davols/tiny-engineer/hardware/boards/main-control-board/main-control-board-rev-3-preview.jpg

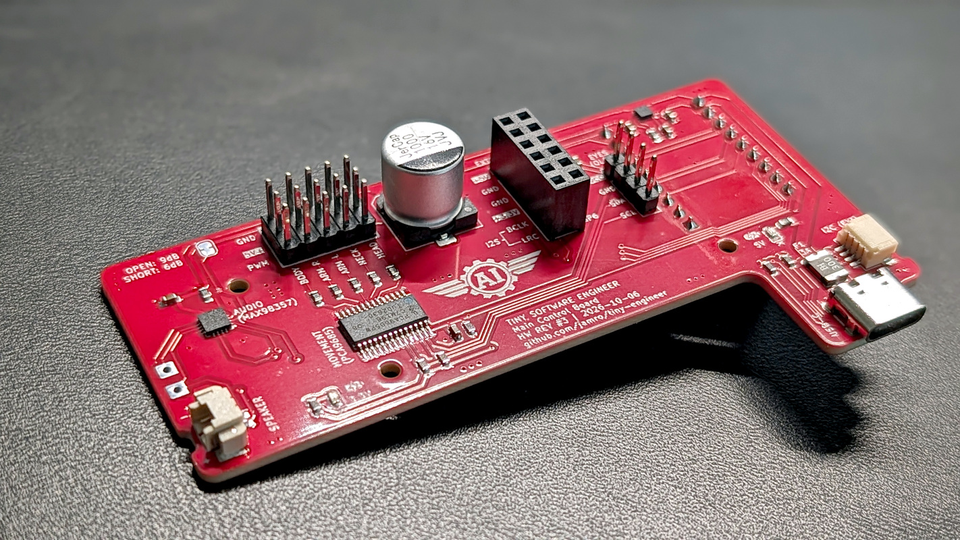
hardware/boards/main-control-board/main-control-board-rev-3-preview.jpg
