davols/tiny-engineer/3d_models/parts/es9051/step/BellyJoint.step

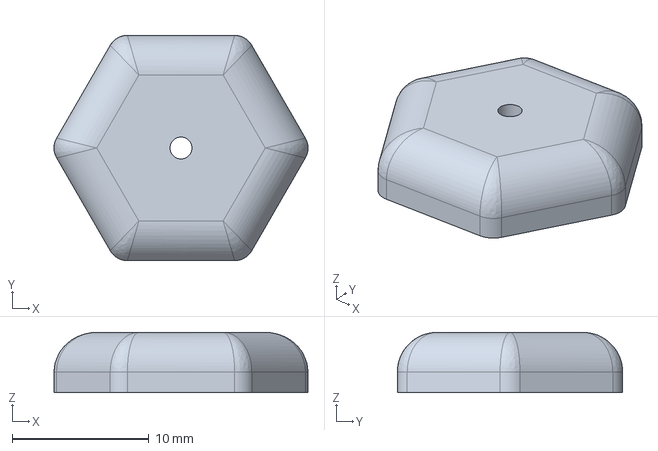
[picture p2: CAD file, 2026-10-21]
3d_models/parts/es9051/step/BellyJoint.step
18.6 x 16.5 x 4.40 mm
