davols/tiny-engineer/3d_models/parts/es9051/step/SeatLeft.step

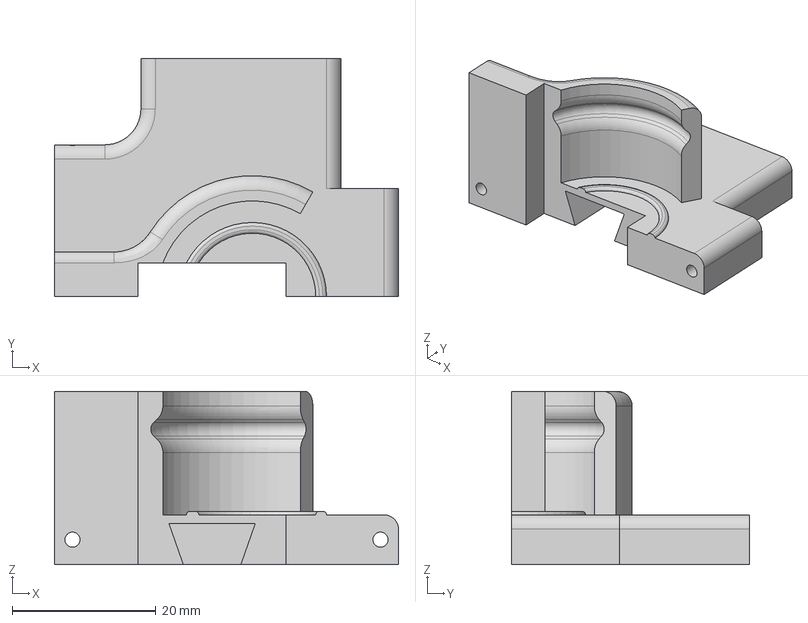
[picture p5: CAD file, 2026-10-20]
3d_models/parts/es9051/step/SeatLeft.step
47.8 x 33.1 x 24.0 mm
