davols/tiny-engineer/3d_models/parts/fs0307/step/BottomCover.step

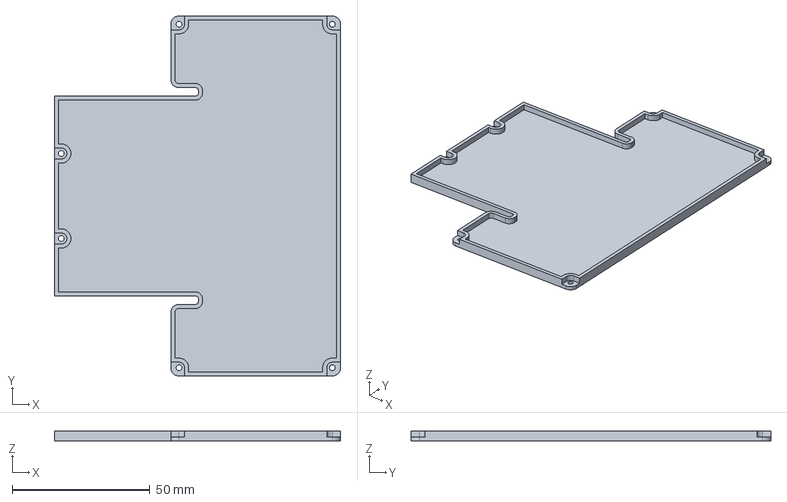
[picture p6: CAD file, 2026-10-20]
3d_models/parts/fs0307/step/BottomCover.step
103.8 x 130.6 x 3.80 mm
