davols/tiny-engineer/3d_models/parts/hd1370a/step/SeatRight.step

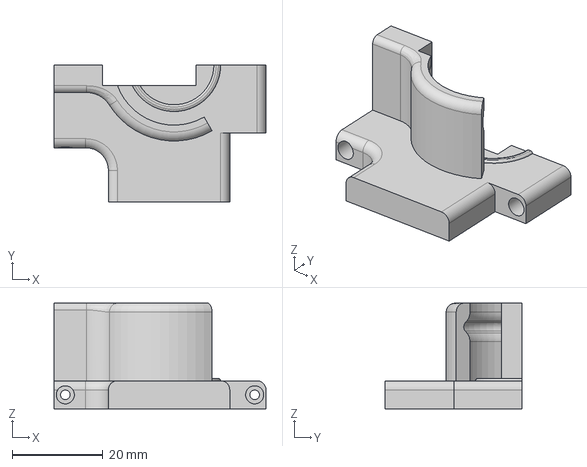
[picture p7: CAD file, 2026-10-20]
3d_models/parts/hd1370a/step/SeatRight.step
46.8 x 30.3 x 23.3 mm
