davols/tiny-engineer/3d_models/parts/sg90/step/SeatRight.step

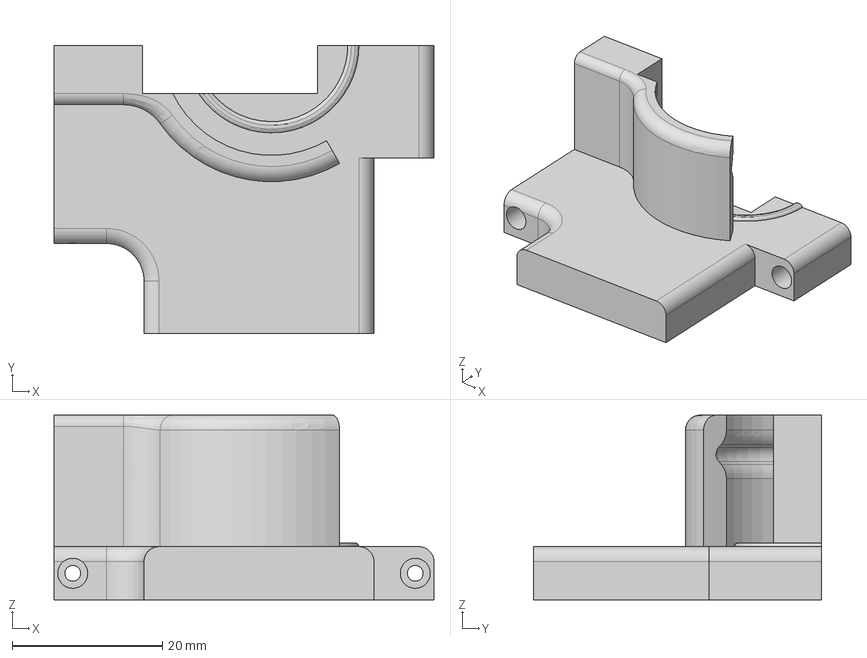
[picture p8: CAD file, 2026-10-20]
3d_models/parts/sg90/step/SeatRight.step
50.7 x 38.4 x 24.6 mm
