davols/tiny-engineer/3d_models/parts/es9051/step/BottomCover.step

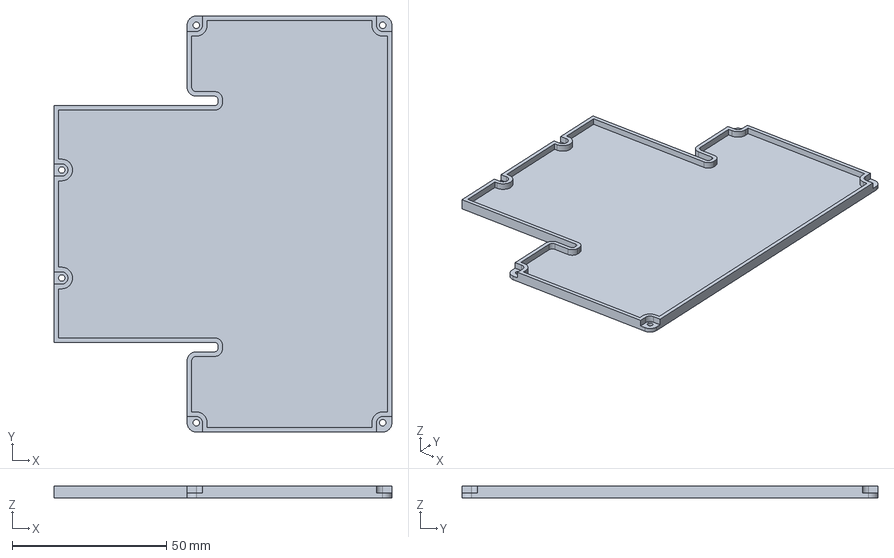
[picture p9: CAD file, 2026-10-20]
3d_models/parts/es9051/step/BottomCover.step
109.5 x 134.8 x 3.80 mm
