davols/tiny-engineer/3d_models/parts/fs0307/step/SeatLeft.step

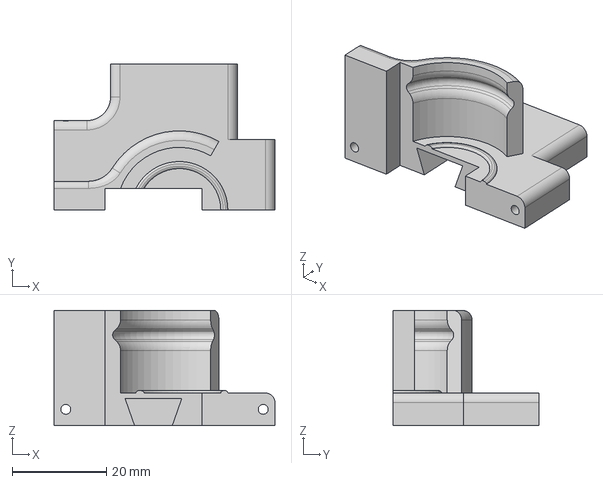
[picture p10: CAD file, 2026-10-20]
3d_models/parts/fs0307/step/SeatLeft.step
46.9 x 31.0 x 24.4 mm
