davols/tiny-engineer/3d_models/parts/sg90/step/BottomCover.step

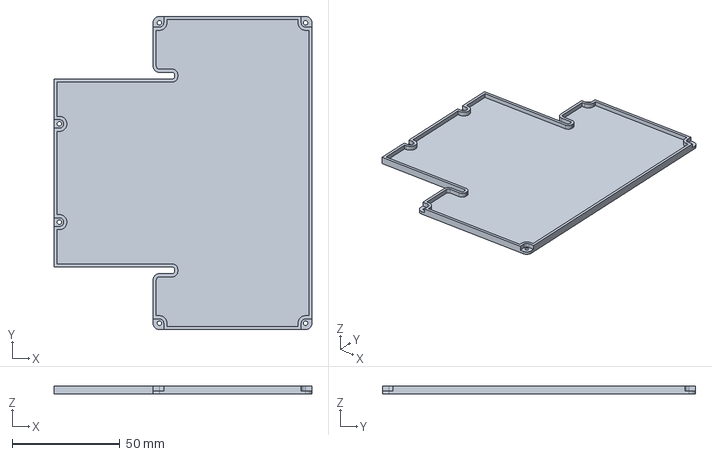
[picture p11: CAD file, 2026-10-20]
3d_models/parts/sg90/step/BottomCover.step
119.8 x 145.4 x 3.80 mm
