davols/tiny-engineer/3d_models/parts/fs0307/step/PartsSetB.step

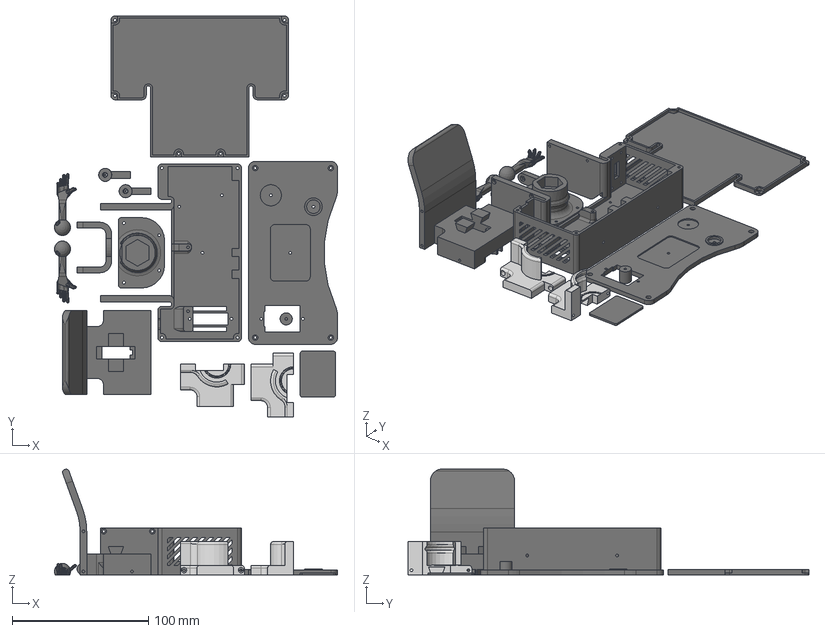
[picture p12: CAD file, 2026-10-20]
3d_models/parts/fs0307/step/PartsSetB.step
208.3 x 294.8 x 77.8 mm
