davols/tiny-engineer/3d_models/parts/hd1370a/step/PartsSetB.step

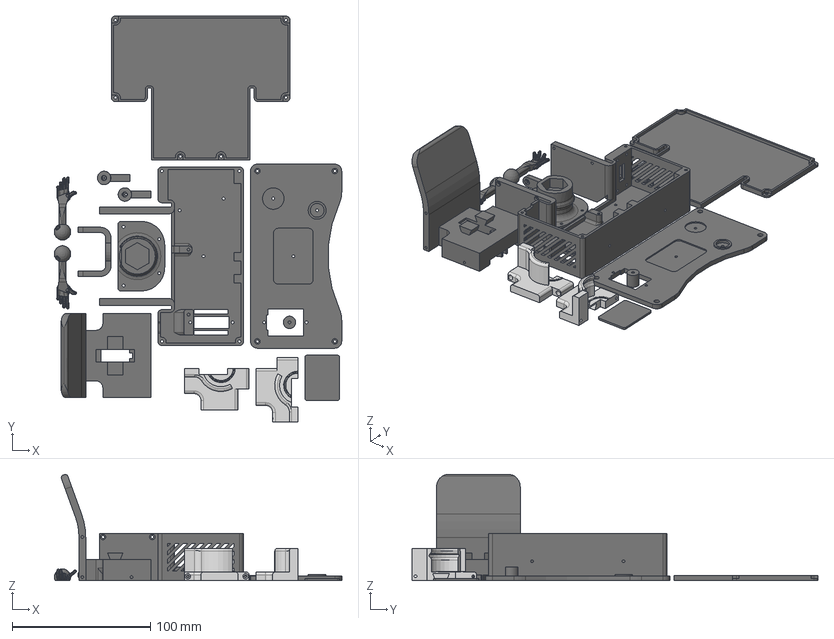
[picture p13: CAD file, 2026-10-20]
3d_models/parts/hd1370a/step/PartsSetB.step
207.9 x 293.6 x 76.8 mm
