davols/tiny-engineer/3d_models/parts/es9051/step/Belly.step

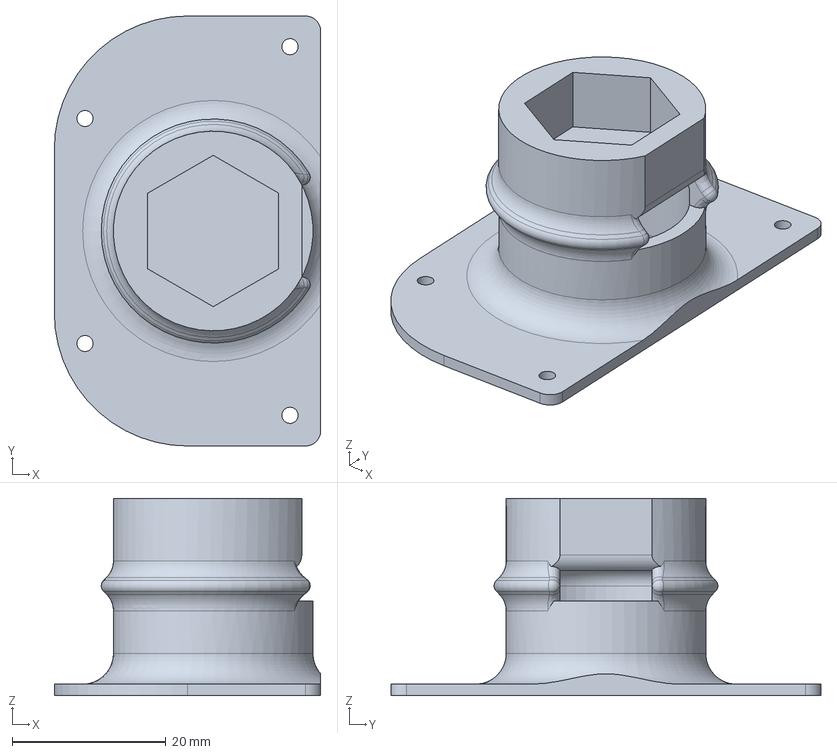
[picture p16: CAD file, 2026-10-20]
3d_models/parts/es9051/step/Belly.step
34.7 x 56.0 x 25.7 mm
