davols/tiny-engineer/3d_models/parts/fs0307/step/Belly.step

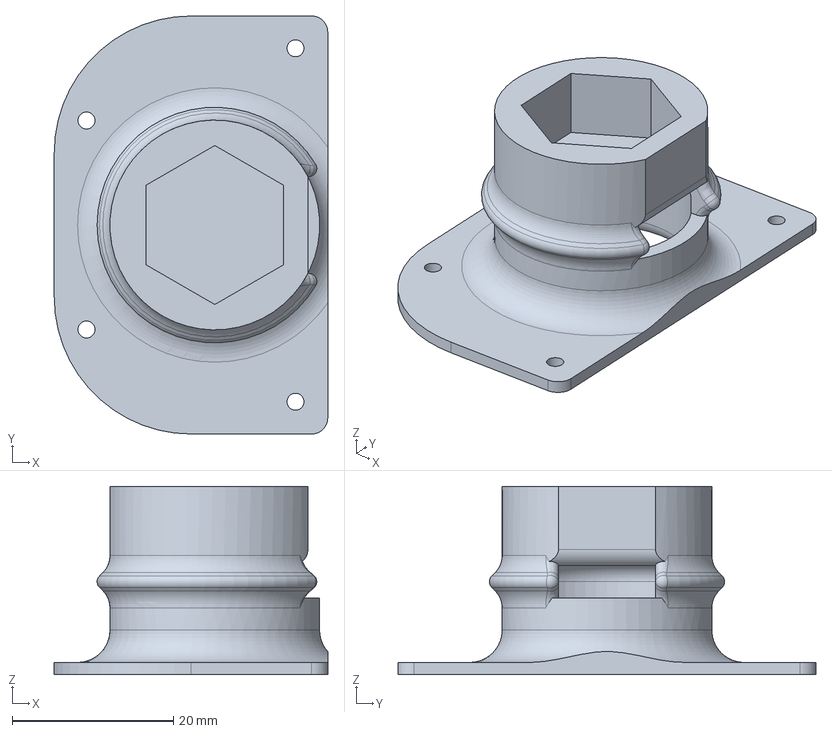
[picture p17: CAD file, 2026-10-20]
3d_models/parts/fs0307/step/Belly.step
33.9 x 51.8 x 23.3 mm
