davols/tiny-engineer/3d_models/parts/hd1370a/step/PartsSetA.step

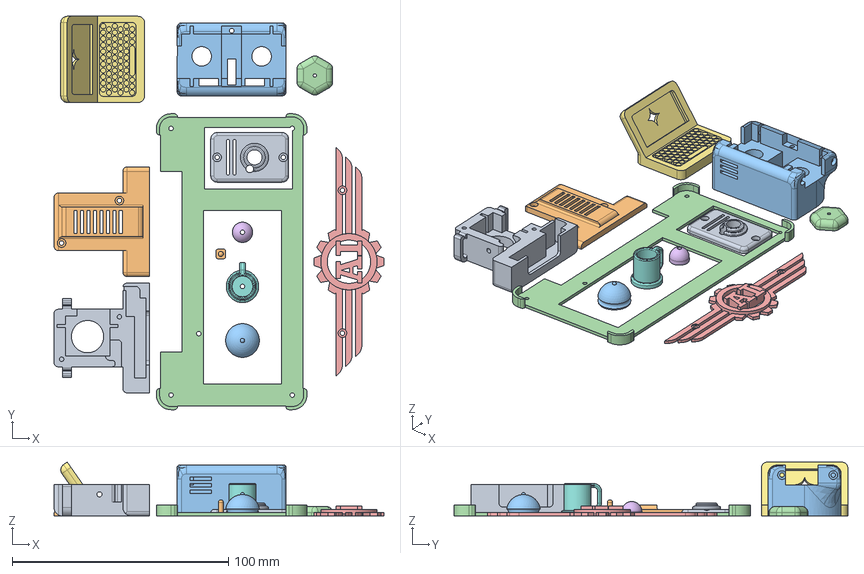
[picture p18: CAD file, 2026-10-20]
3d_models/parts/hd1370a/step/PartsSetA.step
152.5 x 181.8 x 24.9 mm
