davols/tiny-engineer/3d_models/parts/sg90/step/Belly.step

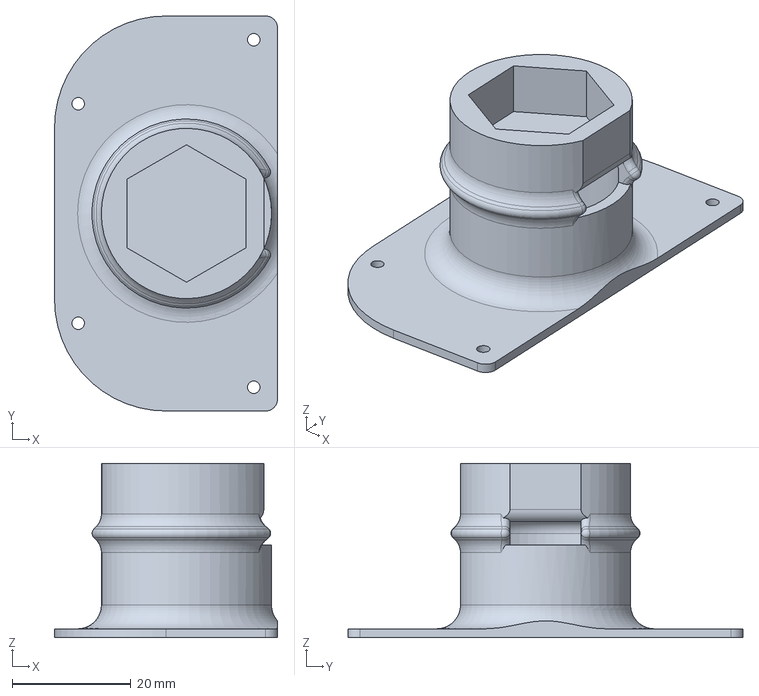
[picture p19: CAD file, 2026-10-20]
3d_models/parts/sg90/step/Belly.step
37.6 x 66.6 x 29.4 mm
