davols/tiny-engineer/3d_models/parts/fs0307/step/PartsSetA.step

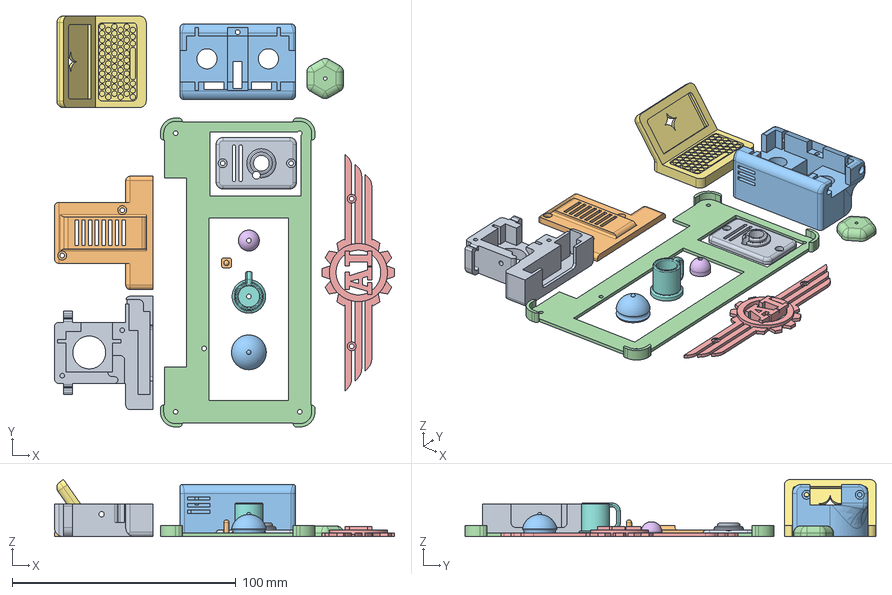
[picture p21: CAD file, 2026-10-20]
3d_models/parts/fs0307/step/PartsSetA.step
152.2 x 183.9 x 25.6 mm
