davols/tiny-engineer/3d_models/parts/hd1370a/step/Belly.step

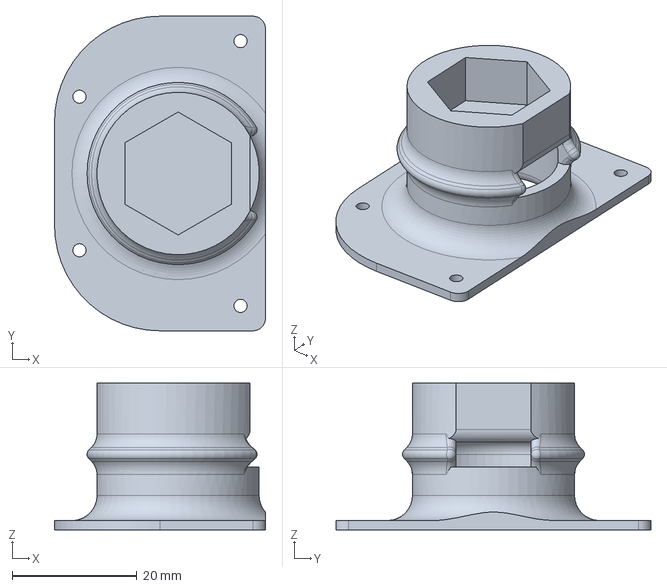
[picture p22: CAD file, 2026-10-20]
3d_models/parts/hd1370a/step/Belly.step
33.8 x 50.4 x 23.5 mm
