davols/tiny-engineer/3d_models/parts/sg90/step/PartsSetA.step

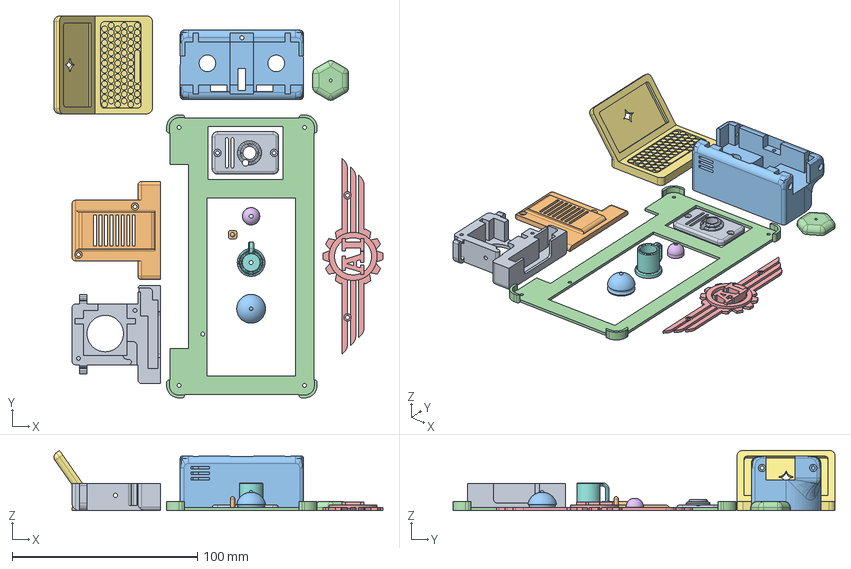
[picture p23: CAD file, 2026-10-20]
3d_models/parts/sg90/step/PartsSetA.step
177.8 x 206.4 x 32.5 mm
