davols/tiny-engineer/(list of files, cad)

Other CAD files:
3d_models/parts/hd1370a/step/BellyJoint.step
3d_models/parts/hd1370a/step/SeatLeft.step
3d_models/parts/es9051/step/SeatRight.step
3d_models/parts/sg90/step/SeatLeft.step
3d_models/parts/fs0307/step/SeatRight.step
3d_models/parts/hd1370a/step/BottomCover.step
3d_models/cad/TinyEngineer.f3d
3d_models/parts/es9051/3mf/Belly.3mf
3d_models/parts/es9051/3mf/BellyJoint.3mf
3d_models/parts/es9051/3mf/BottomCover.3mf
3d_models/parts/es9051/3mf/PartsSetA.3mf
3d_models/parts/es9051/3mf/PartsSetB.3mf
3d_models/parts/es9051/3mf/SeatLeft.3mf
3d_models/parts/es9051/3mf/SeatRight.3mf
3d_models/parts/es9051/stl/Belly.stl
3d_models/parts/es9051/stl/BellyJoint.stl
3d_models/parts/es9051/stl/BottomCover.stl
3d_models/parts/es9051/stl/PartsSetA.stl
3d_models/parts/es9051/stl/PartsSetB.stl
3d_models/parts/es9051/stl/SeatLeft.stl
3d_models/parts/es9051/stl/SeatRight.stl
3d_models/parts/fs0307/3mf/Belly.3mf
3d_models/parts/fs0307/3mf/BellyJoint.3mf
3d_models/parts/fs0307/3mf/BottomCover.3mf
3d_models/parts/fs0307/3mf/PartsSetA.3mf
3d_models/parts/fs0307/3mf/PartsSetB.3mf
3d_models/parts/fs0307/3mf/SeatLeft.3mf
3d_models/parts/fs0307/3mf/SeatRight.3mf
3d_models/parts/fs0307/stl/Belly.stl
3d_models/parts/fs0307/stl/BellyJoint.stl
3d_models/parts/fs0307/stl/BottomCover.stl
3d_models/parts/fs0307/stl/PartsSetA.stl
3d_models/parts/fs0307/stl/PartsSetB.stl
3d_models/parts/fs0307/stl/SeatLeft.stl
3d_models/parts/fs0307/stl/SeatRight.stl
3d_models/parts/hd1370a/3mf/Belly.3mf
3d_models/parts/hd1370a/3mf/BellyJoint.3mf
3d_models/parts/hd1370a/3mf/BottomCover.3mf
3d_models/parts/hd1370a/3mf/PartsSetA.3mf
3d_models/parts/hd1370a/3mf/PartsSetB.3mf
3d_models/parts/hd1370a/3mf/SeatLeft.3mf
3d_models/parts/hd1370a/3mf/SeatRight.3mf
3d_models/parts/hd1370a/stl/Belly.stl
3d_models/parts/hd1370a/stl/BellyJoint.stl
3d_models/parts/hd1370a/stl/BottomCover.stl
3d_models/parts/hd1370a/stl/PartsSetA.stl
3d_models/parts/hd1370a/stl/PartsSetB.stl
3d_models/parts/hd1370a/stl/SeatLeft.stl
3d_models/parts/hd1370a/stl/SeatRight.stl
3d_models/parts/sg90/3mf/Belly.3mf
3d_models/parts/sg90/3mf/BellyJoint.3mf
3d_models/parts/sg90/3mf/BottomCover.3mf
3d_models/parts/sg90/3mf/PartsSetA.3mf
3d_models/parts/sg90/3mf/PartsSetB.3mf
3d_models/parts/sg90/3mf/SeatLeft.3mf
3d_models/parts/sg90/3mf/SeatRight.3mf
3d_models/parts/sg90/stl/Belly.stl
3d_models/parts/sg90/stl/BellyJoint.stl
3d_models/parts/sg90/stl/BottomCover.stl
3d_models/parts/sg90/stl/PartsSetA.stl
3d_models/parts/sg90/stl/PartsSetB.stl
3d_models/parts/sg90/stl/SeatLeft.stl
3d_models/parts/sg90/stl/SeatRight.stl
