davols/tiny-engineer/hardware/boards/main-control-board/main-control-board.kicad_pcb

## KiCad design hardware/boards/main-control-board/main-control-board.kicad_pcb (2026-10-23)

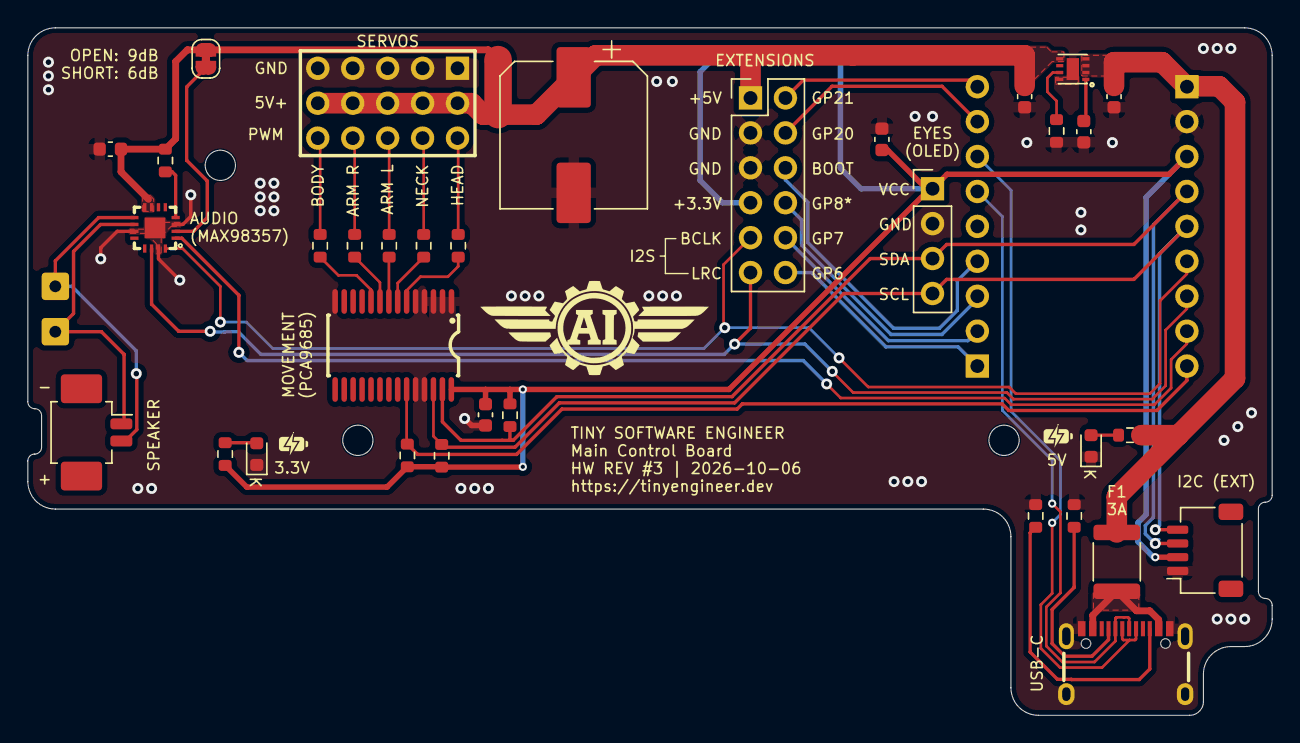
[picture p27: board main-control-board.kicad_pcb from above]

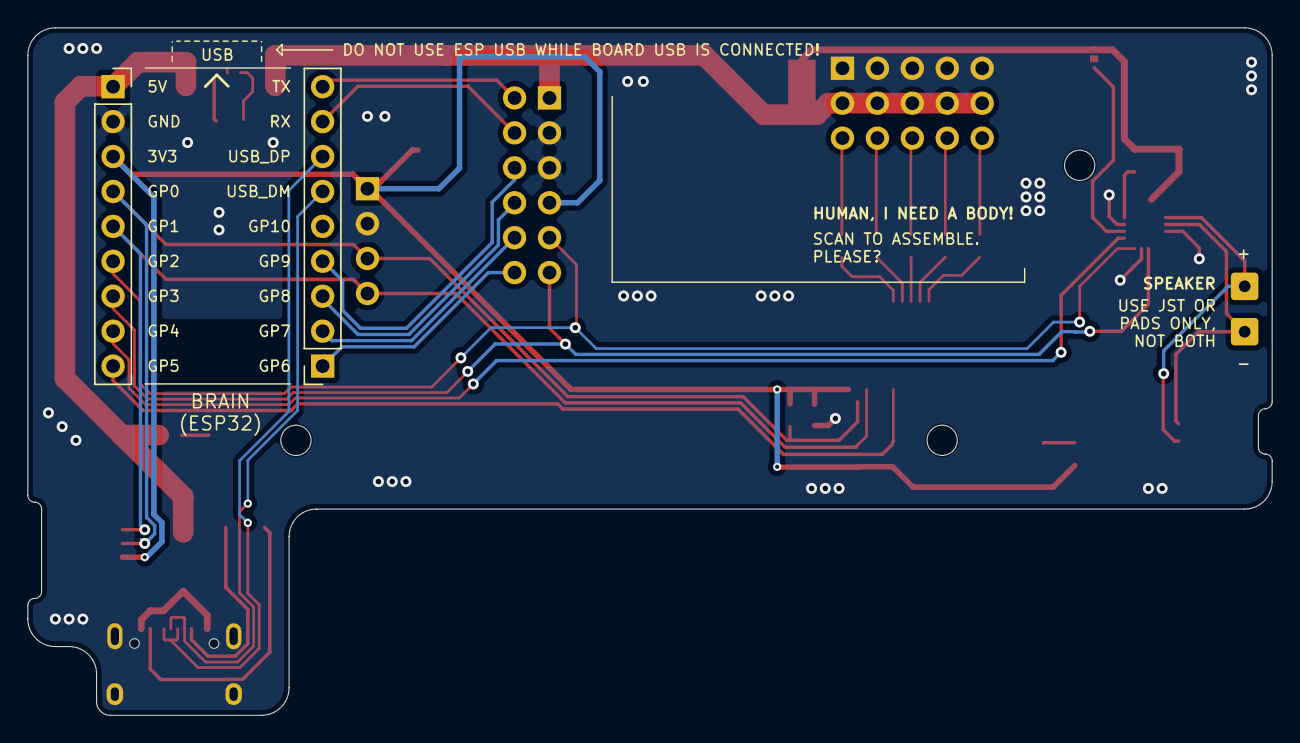
[picture p28: board main-control-board.kicad_pcb from below]

Board: 2 copper layers, 90.5 x 50.0 mm, 42 parts (2 on the bottom side), 40 nets.

Parts:
C1, C3, C4, C5, C6, C7: 100nF; C_0603_1608Metric
C2: 1000uF; CP_Elec_10x10.5
D1, D2: LED; LED_0603_1608Metric
F1: 3A PPTC; Fuse_1812_4532Metric
H1, H2, H3: MountingHole; MountingHole_2.2mm_M2
J1: Conn_01x02_Pin_Speaker; Molex_PicoBlade_53261-0271_1x02-1MP_P1.25mm_Horizontal
J2: Conn_OLED; PinHeader_1x04_P2.54mm_Vertical
J3: Conn_extension; JST_SH_SM04B-SRSS-TB_1x04-1MP_P1.00mm_Horizontal
J4: Conn_02x06_Odd_Even; PinHeader_2x06_P2.54mm_Vertical
J7, J8: Conn_ESP32; PinSocket_1x09_P2.54mm_Vertical
JP1: SolderJumper_gain_6dB_limit; SolderJumper-2_P1.3mm_Bridged_RoundedPad1.0x1.5mm
NT1: NetTie_2; NetTie-2_SMD_Pad2.0mm
R1, R2: 5.1k; R_0603_1608Metric
R3: 10k; R_0603_1608Metric
R4, R5: 4.7k; R_0603_1608Metric
R6, R7, R8, R9, R10: 220; R_0603_1608Metric
R11: 2.2k; R_0603_1608Metric
R12: 1M; R_0603_1608Metric
R13, R14: 1k; R_0603_1608Metric
TP1, TP2: TestPoint; SolderWire-0.25sqmm_1x01_D0.65mm_OD2mm
U1: PCA9685PW,118; TSSOP-28_L9.7-W4.4-P0.65-LS6.4-TL
U2: HX PZ2.54-3X5P ZZ; HDR-TH_15P-P2.54-V-M-R3-C5-S7.5
U3: MAX98357AETE+T; TQFN-16_L3.0-W3.0-P0.50-BL-EP1.5
U4: TPS259571DSGR; WSON-8_L2.0-W2.0-P0.50-TL-EP
USB1: TYPE-C 16PIN 2MD; USB-C-SMD_TYPE-C-16PIN-2MD-073

Connections:
+3.3V: C1.2, C7.1, J2.1, J3.2, J4.7, J7.3, R3.1, R4.1, R5.1, R13.1, U1.28 (VDD)
+5V: C4.2, F1.1, J7.1, R11.1, U4.2 (EN/UVLO), U4.3 (IN), U4.4 (IN)
/Audio/AUDIO_5V: C3.2, JP1.1 (A), NT1.2, R12.1, U3.7 (VDD), U3.8 (VDD)
/ESP32/GP5: J7.9, R3.2, U1.23 (~OE)
/ESP32/GP6: J4.12, J8.1
/ESP32/GP7: J4.10, J8.2
/ESP32/GP8: J4.8, J8.3
/ESP32/GP9: J4.6, J8.4
/ESP32/GP20: J4.4, J8.8
/ESP32/GP21: J4.2, J8.9
/I2C_SCL: J2.4, J3.4, J7.5, R4.2, U1.26 (SCL)
/I2C_SDA: J2.3, J3.3, J7.4, R5.2, U1.27 (SDA)
/I2S_BCLK: J4.9, J7.6, U3.16 (BCLK)
/I2S_DIN: J7.8, U3.1 (DIN)
/I2S_LRC: J4.11, J7.7, U3.14 (LRCLK)
/PCA/SERVO_5V: C2.1, C5.2, J4.1, NT1.1, U2.2, U2.5, U2.8, U2.11, U2.14, U4.5 (OUT)
/USB/USB_VBUS: F1.2, USB1.A4B9 (VBUS), USB1.B4A9 (VBUS)
/USB_D+: J8.7, USB1.A6 (Dp1), USB1.B6 (Dp2)
/USB_D-: J8.6, USB1.A7 (Dn1), USB1.B7 (Dn2)
GND: C1.1, C2.2, C3.1, C4.1, C5.1, C6.2, C7.2, D1.1 (K), D2.1 (K), J2.2, J3.1, J4.3, J4.5, J7.2, R1.1, R2.1, R14.2, U1.1 (A0), U1.2 (A1), U1.3 (A2), U1.4 (A3), U1.5 (A4), U1.14 (VSS), U1.24 (A5), U1.25 (EXTCLK), U2.1, U2.4, U2.7, U2.10, U2.13, U3.3 (GND), U3.11 (GND), U3.15 (GND), U3.17 (EP), U4.8 (GND), U4.9 (GND), USB1.13 (EH), USB1.14 (EH), USB1.A1B12 (GND), USB1.B1A12 (GND)
unnamed: D1.2 (A), R11.2
unnamed: D2.2 (A), R13.2
unnamed: J1.1, TP1.1 (1_1), U3.10 (OUTN)
unnamed: J1.2, TP2.1 (1_1), U3.9 (OUTP)
unnamed: JP1.2 (B), U3.2 (GAIN_SLOT)
unnamed: R6.2, U2.3
unnamed: R7.2, U2.6
unnamed: R8.2, U2.9
unnamed: R9.2, U2.12
unnamed: R10.2, U2.15
unnamed: R6.1, U1.6 (LED0)
unnamed: R7.1, U1.7 (LED1)
unnamed: R8.1, U1.8 (LED2)
unnamed: R9.1, U1.9 (LED3)
unnamed: R10.1, U1.10 (LED4)
unnamed: R12.2, U3.4 (~SD_MODE)
unnamed: R14.1, U4.7 (ILM)
unnamed: C6.1, U4.1 (dVdt)
unnamed: R1.2, USB1.A5 (CC1)
unnamed: R2.2, USB1.B5 (CC2)
