davols/tiny-engineer/(commit log)

2026-10-20 fix(cad): add a flexible belly joint to unload the torso servo shaft (#86)
    [Belly.3mf, Belly.step, Belly.stl, BellyJoint.3mf, BellyJoint.step, BellyJoint.stl, PartsSetA.3mf, PartsSetA.step]
2026-10-20 fix(firmware): update servo identification logic to accommodate body joint with increased delta range
2026-10-20 fix(cad): tighten belly runner
    [BottomCover.3mf, BottomCover.step, BottomCover.stl, PartsSetB.3mf, PartsSetB.step, PartsSetB.stl, SeatLeft.3mf, SeatLeft.step]
2026-10-21 fix(cad): reduce belly joint slack
    [BellyJoint.3mf, BellyJoint.step, BellyJoint.stl, TinyEngineer.f3d]
2026-10-21 docs(cad): update assembly instructions for Belly and Chair components, adding 'BellyJoint' and clarifying alignment steps
2026-10-21 docs(cad): add description for BellyJoint component in 3D models README
2026-10-21 fix(ci): improve KiCad installation process in CI workflow with retry logic and version checks
2026-10-22 add extension port
    [main-control-board-esp32.kicad_sch, main-control-board.kicad_pcb, main-control-board.kicad_sch]
2026-10-22 update BOM
    [main-control-board.kicad_pcb, main-control-board.kicad_sch]
2026-10-22 update README.md for main control board: clarify extension port details and specify strapping pins and UART connections
2026-10-22 update silkscreen layer for main control board: add knockout effect to VCC and voltage labels
    [main-control-board.kicad_pcb]
2026-10-22 add ESP antenna keepout
    [main-control-board.kicad_pcb]
2026-10-22 add 100nF to U4 dVdt
    [main-control-board-pca.kicad_sch, main-control-board.kicad_pcb]
2026-10-22 add capacitor next to pin 28 of PCA
    [main-control-board-esp32.kicad_sch, main-control-board.kicad_pcb]
2026-10-22 update hardware documentation: clarify power distribution and GPIO pin usage on the main control board, including details on USB-C connections and extension headers
2026-10-22 update silkscreen text on main control board: change label from "GP9" to "BOOT" and modify "GP8" to "GP8*"
    [main-control-board.kicad_pcb]
2026-10-22 doc(extension): document push-button extension: implement outbound event hub and button event publishing, including new settings and UI controls
2026-10-22 feat(firmware): add push-button extension
    add settings, outbound event hub, and WebSocket support for button events; update documentation and hardware references
2026-10-22 refactor(push-button): enhance button event handling and WebSocket integration
2026-10-23 feat(api): enhance access token handling and WebSocket disconnection
    * Updated API documentation to clarify that setting or rotating a non-empty access token will disconnect current WebSocket subscribers, requiring them to reconnect with the new token.
    * Implemented a new function to disconnect all WebSocket clients upon access token rotation.
    * Modified settings handler to invoke the disconnection function when the access token is changed.
2026-10-24 docs(firmware): update specs with push-button extension with outbound event hub
2026-10-24 feat(firmware): implement gesture recognition for button events (click, double_click, long_click)
2026-10-24 feat(firmware): add configurable push-button pin and update documentation
2026-10-29 docs(docs): add hardware BOM with revision lists and supplier pricing
